borisnimcevic/lilordag_pcb_logo_test/parts/BK-912-TR-batt-holder/BK-912-TR.step

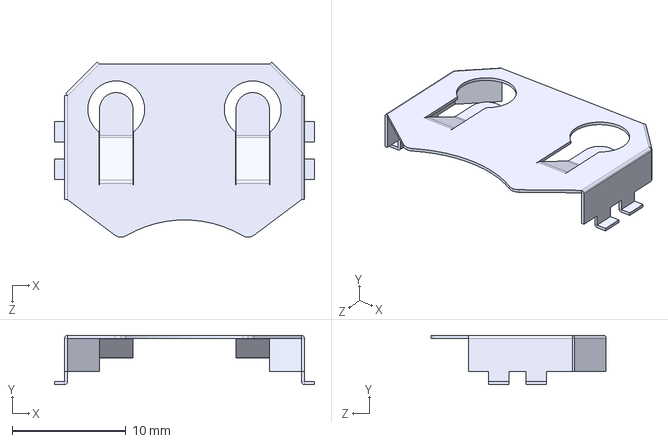
[picture p1: CAD file, 2022-09-27]
parts/BK-912-TR-batt-holder/BK-912-TR.step
22.9 x 4.32 x 15.4 mm
