borisnimcevic/lilordag_pcb_logo_test/parts/button_TL3305AF260QG/TL3305AF260QG.step

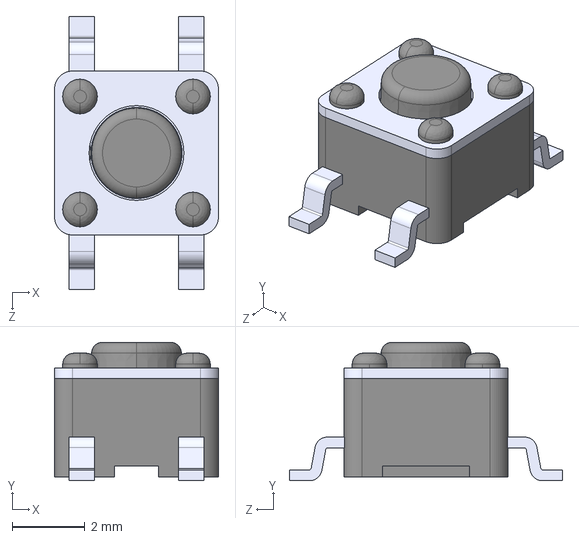
[picture p2: CAD file, 2022-11-28]
parts/button_TL3305AF260QG/TL3305AF260QG.step
4.50 x 3.80 x 7.50 mm
