borisnimcevic/lilordag_pcb_logo_test/parts/ESP32-C3-MINI/ESP32-C3-MINI-1-N4--3DModel-STEP-1.STEP

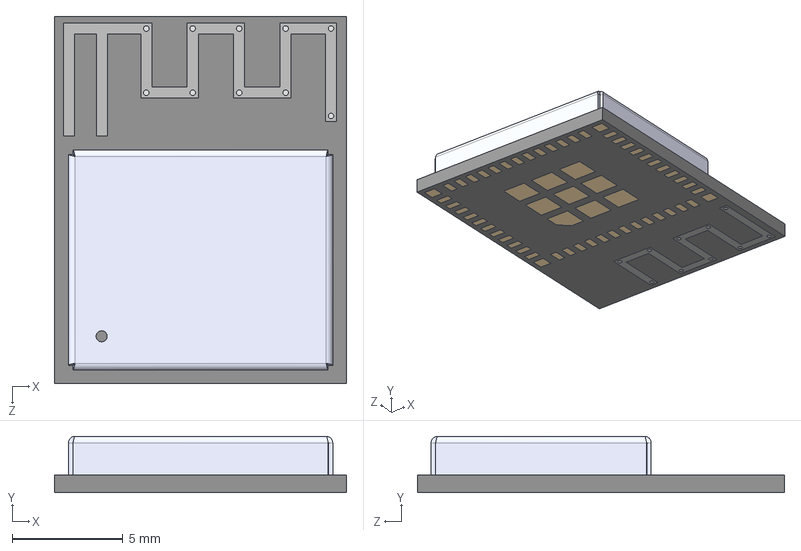
[picture p3: CAD file, 2022-09-29]
parts/ESP32-C3-MINI/ESP32-C3-MINI-1-N4--3DModel-STEP-1.STEP
13.2 x 2.55 x 16.6 mm
