borisnimcevic/lilordag_pcb_logo_test/parts/HEADER-4-PIN/TSW-104-23-F-S.step

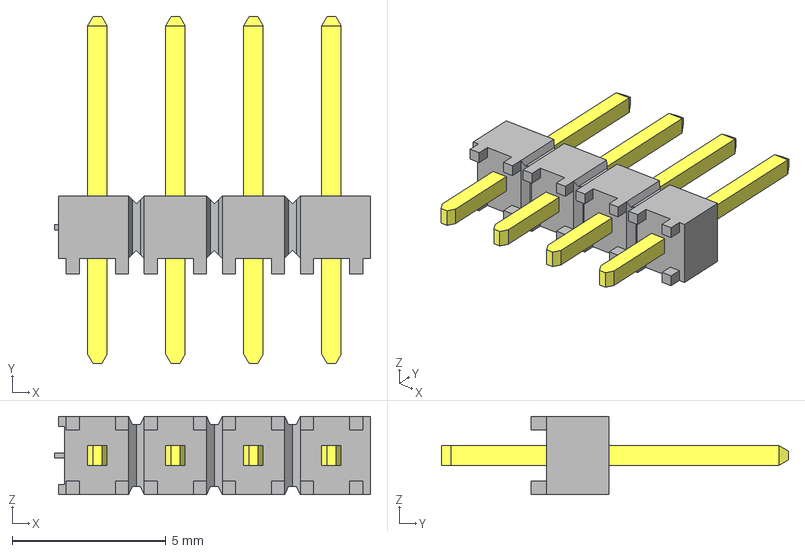
[picture p4: CAD file, 2022-09-29]
parts/HEADER-4-PIN/TSW-104-23-F-S.step
10.3 x 11.3 x 2.54 mm
T-1S6-16-TSW-1-23-4-S
TSW-104-23-F-S_body
