borisnimcevic/lilordag_pcb_logo_test/parts/HEADER-6-PIN/5-146282-6.step

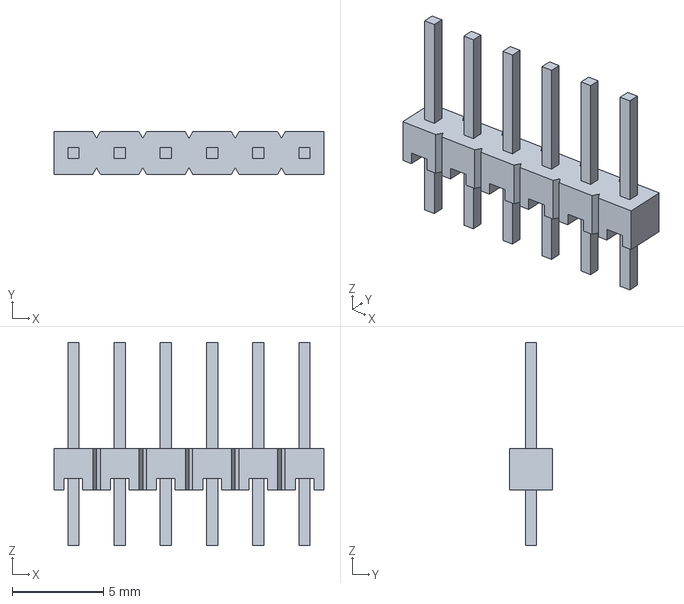
[picture p5: CAD file, 2022-10-31]
parts/HEADER-6-PIN/5-146282-6.step
14.8 x 2.34 x 11.2 mm
