borisnimcevic/lilordag_pcb_logo_test/parts/PCM12SMTR/PCM12SMTR.step

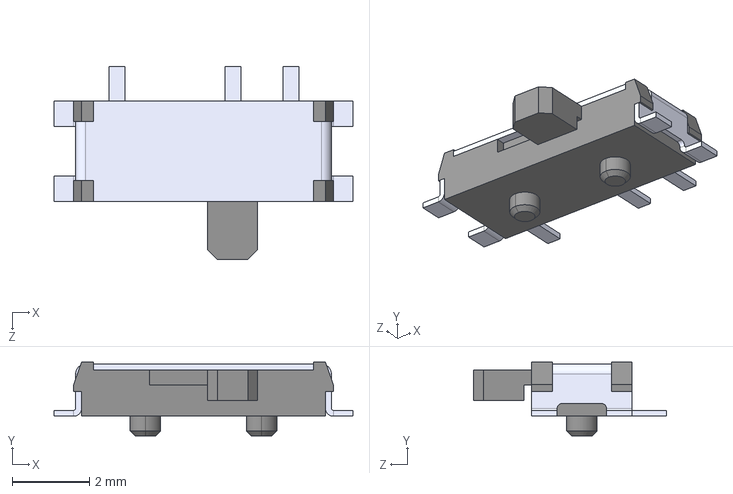
[picture p6: CAD file, 2022-09-26]
parts/PCM12SMTR/PCM12SMTR.step
7.72 x 1.91 x 4.98 mm
