borisnimcevic/lilordag_pcb_logo_test/parts/SSM3J35MFV/RSM002P03T2L.STEP

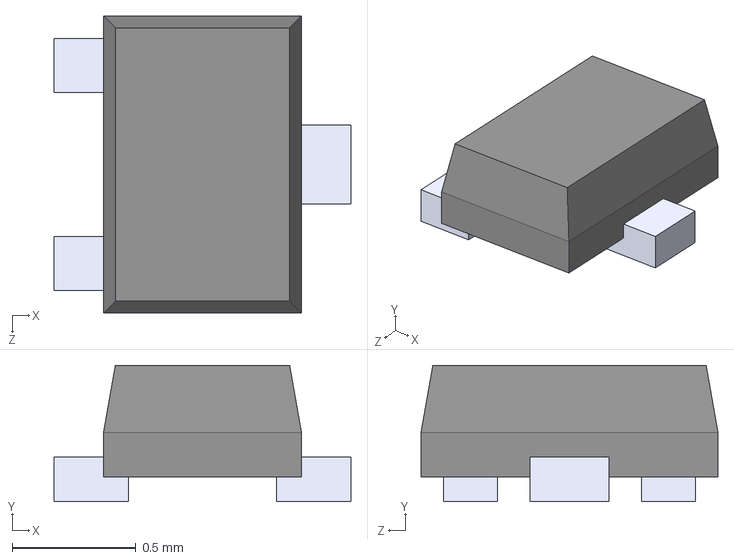
[picture p7: CAD file, 2022-09-29]
parts/SSM3J35MFV/RSM002P03T2L.STEP
1.20 x 0.55 x 1.20 mm
