borisnimcevic/lilordag_pcb_logo_test/parts/switch-TL3301AF260QG/TL3301AF260QG.step

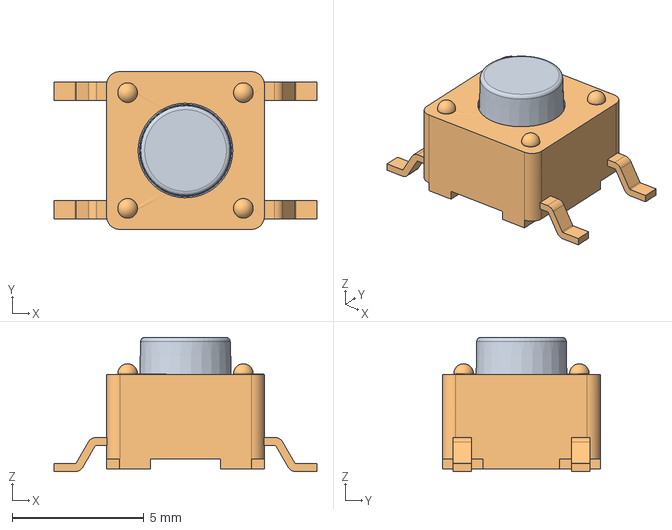
[picture p8: CAD file, 2022-09-29]
parts/switch-TL3301AF260QG/TL3301AF260QG.step
10.0 x 6.00 x 5.10 mm
