borisnimcevic/lilordag_pcb_logo_test/parts/USBC-USB4105-GF-A/USB4105-GF-A--3DModel-STEP-56544.STEP

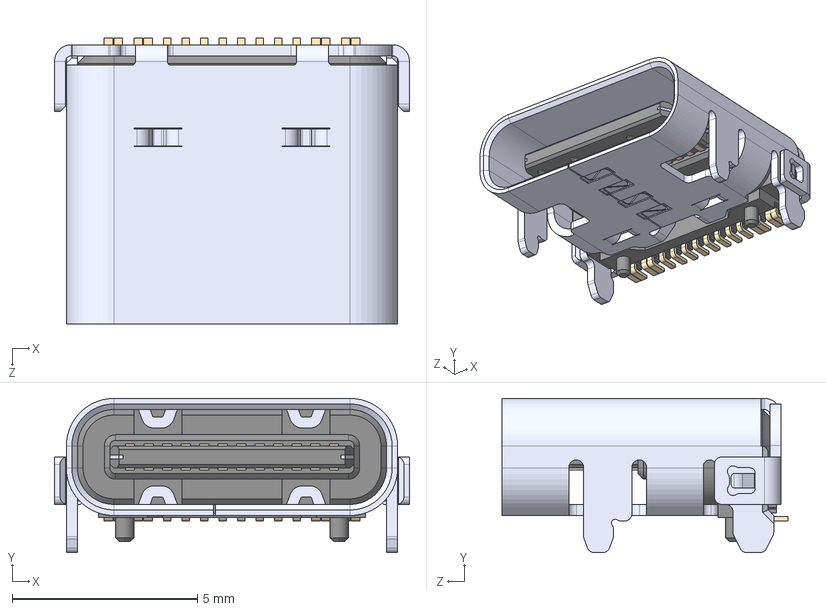
[picture p9: CAD file, 2022-09-27]
parts/USBC-USB4105-GF-A/USB4105-GF-A--3DModel-STEP-56544.STEP
9.58 x 4.16 x 7.71 mm
