borisnimcevic/lilordag_pcb_logo_test/parts/WS2812B/WS2812B-B.step

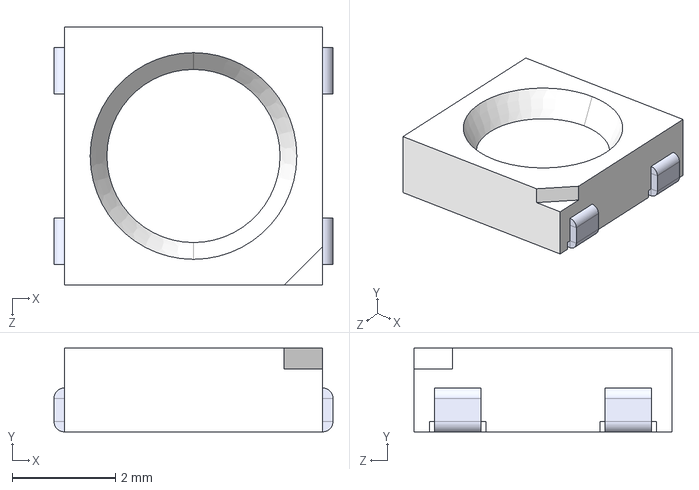
[picture p10: CAD file, 2022-11-01]
parts/WS2812B/WS2812B-B.step
5.40 x 1.62 x 5.00 mm
