borisnimcevic/lilordag_pcb_logo_test/parts/HEADER-7-PIN/826629-7.step

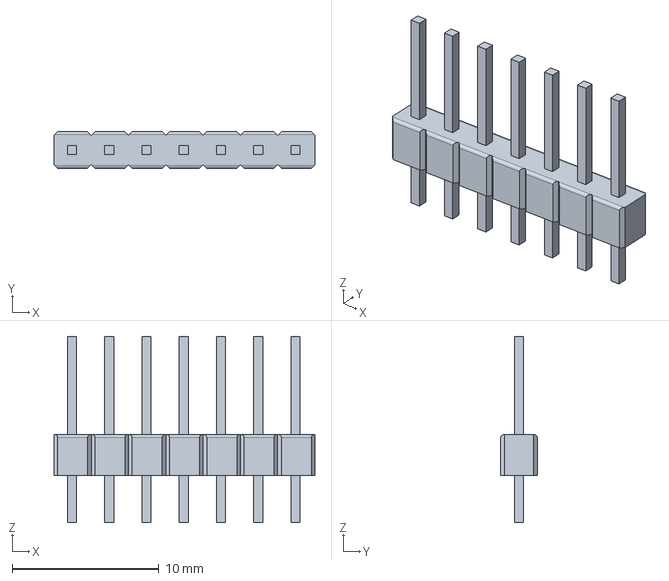
[picture p11: CAD file, 2022-11-01]
parts/HEADER-7-PIN/826629-7.step
17.8 x 2.50 x 12.7 mm
