borisnimcevic/lilordag_pcb_logo_test/(commit log)

2022-08-22 Init repo.
    [lilordag_pcb_logo_test.kicad_pcb, lilordag_pcb_logo_test.kicad_sch]
2022-08-22 PCB edges set.
    [lilordag_pcb_logo_test.kicad_pcb]
2022-08-22 Importing tower designs.
    [lilordag_pcb_logo_test.kicad_pcb]
2022-08-23 Testing inkscape pcb extension.
    [lilordag_pcb_logo_test.kicad_pcb]
2022-08-25 Created a table of possible collors (one pcb side).
2022-08-25 Added 4 simple versiions 15x15mm.
    [lilordag_pcb_logo_test.kicad_pcb]
2022-08-25 Added rounded edges.
    [lilordag_pcb_logo_test.kicad_pcb]
2022-08-25 Added candy logos.
    [lilordag_pcb_logo_test.kicad_pcb]
2022-08-27 Updated PCB info.
    [lilordag_pcb_logo_test.kicad_pcb]
2022-08-31 Experimenting with multiple layers in one.
    [lilordag_pcb_logo_test.kicad_pcb]
2022-09-01 Added tower with stars logo.
    [lilordag_pcb_logo_test.kicad_pcb]
2022-09-02 Added mounting holes.
    [lilordag_pcb_logo_test.kicad_pcb, lilordag_pcb_logo_test.kicad_sch]
2022-09-04 Added astable multivibrator to the schematic.
    [lilordag_pcb_logo_test.kicad_sch]
2022-09-05 Added BOM to the astable multivibrator.
2022-09-05 Added values to the astable multivibrator.
    [lilordag_pcb_logo_test.kicad_sch]
2022-09-05 Added labels to the schematic.
    [lilordag_pcb_logo_test.kicad_sch]
2022-09-23 Added more LED's to tests loading multivibrator.
    [lilordag_pcb_logo_test.kicad_sch]
2022-09-26 Updated README with the link to sliding switch.
2022-09-26 Added datasheet for the sliding switch.
2022-09-26 Downloaded symbol, footprint and 3D for the switch.
    [PCM12SMTR--3DModel-STEP-56544.STEP, PCM12SMTR.step]
2022-09-26 Added the switch to the schematic.
    [lilordag_pcb_logo_test.kicad_sch]
2022-09-26 Added parts to the PCB and added 3D to switch.
    [lilordag_pcb_logo_test.kicad_pcb, lilordag_pcb_logo_test.kicad_sch]
2022-09-27 Added LDO and ESP32-C3.
    [ESP32-C3-WROOM-02-N4--3DModel-STEP-269445.STEP, ESP32-C3-WROOM-02-N4.step, lilordag_pcb_logo_test.kicad_pcb, lilordag_pcb_logo_test.kicad_sch]
2022-09-27 Connected the switch.
    [lilordag_pcb_logo_test.kicad_pcb, lilordag_pcb_logo_test.kicad_sch]
2022-09-27 Added npn LED drivers.
    [lilordag_pcb_logo_test.kicad_sch]
2022-09-27 Added PNP driver.
    [lilordag_pcb_logo_test.kicad_pcb, lilordag_pcb_logo_test.kicad_sch]
2022-09-27 Added USBC
    [USB4105-GF-A--3DModel-STEP-56544.STEP, lilordag_pcb_logo_test.kicad_pcb, lilordag_pcb_logo_test.kicad_sch]
2022-09-27 Added 2 CR2032 battery holders.
    [BK-912-TR--3DModel-STEP-56544.STEP, BK-912-TR.step, lilordag_pcb_logo_test.kicad_pcb, lilordag_pcb_logo_test.kicad_sch]
2022-09-27 Made a todo list on the schematic.
    [lilordag_pcb_logo_test.kicad_sch]
2022-09-29 Added reverse polarity protection.
    [lilordag_pcb_logo_test.kicad_sch]
2022-09-29 Added the protection circuit to the PCB.
    [RSM002P03T2L.STEP, lilordag_pcb_logo_test.kicad_pcb]
2022-09-29 Added selector between battery and USB.
    [lilordag_pcb_logo_test.kicad_pcb, lilordag_pcb_logo_test.kicad_sch]
2022-09-29 Added an on-off switch to the battery.
    [leds.kicad_sch, lilordag_pcb_logo_test.kicad_pcb, lilordag_pcb_logo_test.kicad_sch]
2022-09-29 Added datasheet for the LED and assigned 3d parts.
    [leds.kicad_sch, lilordag_pcb_logo_test.kicad_pcb, lilordag_pcb_logo_test.kicad_sch]
2022-09-29 Downloaded assets for the esp32-c3-mini.
    [ESP32-C3-MINI-1-N4--3DModel-STEP-1.STEP, ESP32-C3-MINI-1-N4.step, ESP32-C3-WROOM-02-N4--3DModel-STEP-269445.STEP, ESP32-C3-WROOM-02-N4.step, lilordag_pcb_logo_test.kicad_pcb, lilordag_pcb_logo_test.kicad_sch]
2022-09-29 Added esp32c3mini to the schematic and the pcb.
    [lilordag_pcb_logo_test.kicad_pcb, lilordag_pcb_logo_test.kicad_sch]
2022-09-29 Added reset button for the ESP.
    [TL3301AF260QG--3DModel-STEP-520916.STEP, TL3301AF260QG.step, lilordag_pcb_logo_test.kicad_pcb, lilordag_pcb_logo_test.kicad_sch]
2022-09-29 Added 4 pin header.
    [TSW-104-23-F-S.step, lilordag_pcb_logo_test.kicad_pcb, lilordag_pcb_logo_test.kicad_sch]
2022-10-16 sorted BOM
2022-10-17 updated BOM
2022-10-31 Added 6 pin header
    [5-146282-6.step, lilordag_pcb_logo_test.kicad_sch]
2022-11-01 Updated power organization
    [lilordag_pcb_logo_test.kicad_sch]
2022-11-01 Fixed most of the power errors
    [lilordag_pcb_logo_test.kicad_sch]
2022-11-01 Imported new symbols into the PCB
2022-11-01 Connected RGBs in a new sheet
    [RGB-LEDs.kicad_sch]
2022-11-01 Downloaded assests for WS23812B - rgb
    [WS2812B-B.step]
2022-11-01 Downloaded assests for 7 header
    [826629-7.step]
2022-11-20 updated pin breakout
    [lilordag_pcb_logo_test.kicad_pcb, lilordag_pcb_logo_test.kicad_sch]
2022-11-20 schematic organization
    [lilordag_pcb_logo_test.kicad_sch]
2022-11-20 Added test points and power LED.
    [RGB-LEDs.kicad_sch, lilordag_pcb_logo_test.kicad_pcb, lilordag_pcb_logo_test.kicad_sch]
2022-11-20 routed USB
    [lilordag_pcb_logo_test.kicad_pcb, lilordag_pcb_logo_test.kicad_sch]
2022-11-20 positioning components on the board
    [lilordag_pcb_logo_test.kicad_pcb, lilordag_pcb_logo_test.kicad_sch]
2022-11-25 Positioned multi vibrator
    [lilordag_pcb_logo_test.kicad_pcb]
2022-11-25 Main schematic aranged
    [lilordag_pcb_logo_test.kicad_pcb]
2022-11-25 Added 10x10mm logo
    [lilordag_pcb_logo_test.kicad_pcb, lilordag_pcb_logo_test.kicad_sch]
2022-11-26 All the elements are on the board
    [lilordag_pcb_logo_test.kicad_pcb]
2022-11-26 outter logos locked
    [lilordag_pcb_logo_test.kicad_pcb]
2022-11-26 left lide logos locked
    [lilordag_pcb_logo_test.kicad_pcb]
2022-11-27 Logos locked
    [lilordag_pcb_logo_test.kicad_pcb]
2022-11-27 Added 3d model for RGBs
    [lilordag_pcb_logo_test.kicad_pcb]
2022-11-27 USB and battery power installed
    [lilordag_pcb_logo_test.kicad_pcb]
2022-11-28 Vibrator wired in
    [lilordag_pcb_logo_test.kicad_pcb]
2022-11-28 Added switch 3d models
    [TL3301AF260QG.step, TL3305AF260QG.step]
2022-11-28 Breakout wired in
    [lilordag_pcb_logo_test.kicad_pcb, lilordag_pcb_logo_test.kicad_sch]
2022-11-28 Buttons wired in
    [lilordag_pcb_logo_test.kicad_pcb]
2022-11-28 RGBs are wired in
    [lilordag_pcb_logo_test.kicad_pcb]
2022-11-28 Arranding LEDs
    [lilordag_pcb_logo_test.kicad_pcb]
2022-11-28 Bottom left LEDs arranged
    [lilordag_pcb_logo_test.kicad_pcb]
2022-11-28 Left side LEDs arranged
    [lilordag_pcb_logo_test.kicad_pcb]
2022-11-29 Top LEDs arranged.
    [lilordag_pcb_logo_test.kicad_pcb]
2022-11-29 Right LEDs arranged
    [lilordag_pcb_logo_test.kicad_pcb]
2022-11-29 Bottom right LEDs arranged
    [lilordag_pcb_logo_test.kicad_pcb]
2022-11-29 Rearranged LEDs
    [lilordag_pcb_logo_test.kicad_pcb]
2022-11-29 Left LEDs wired in
    [lilordag_pcb_logo_test.kicad_pcb]
2022-11-30 No pcb errors
    [lilordag_pcb_logo_test.kicad_pcb]
2022-11-30 Added labels
    [lilordag_pcb_logo_test.kicad_pcb]
2022-11-30 Rev 1.0
    [lilordag_pcb_logo_test.kicad_pcb]
2023-01-12 Updated rev and date
    [RGB-LEDs.kicad_sch, leds.kicad_sch, lilordag_pcb_logo_test.kicad_pcb, lilordag_pcb_logo_test.kicad_sch]
