borisnimcevic/lilordag_pcb_logo_test/(notices)

Notices in the files:
parts/HEADER-4-PIN/TSW-104-23-F-S.step:
author */ ('License CC BY-ND 4.0'),
